a-bobadilla/Smart-Ovitramp/assets/prub1.jpg

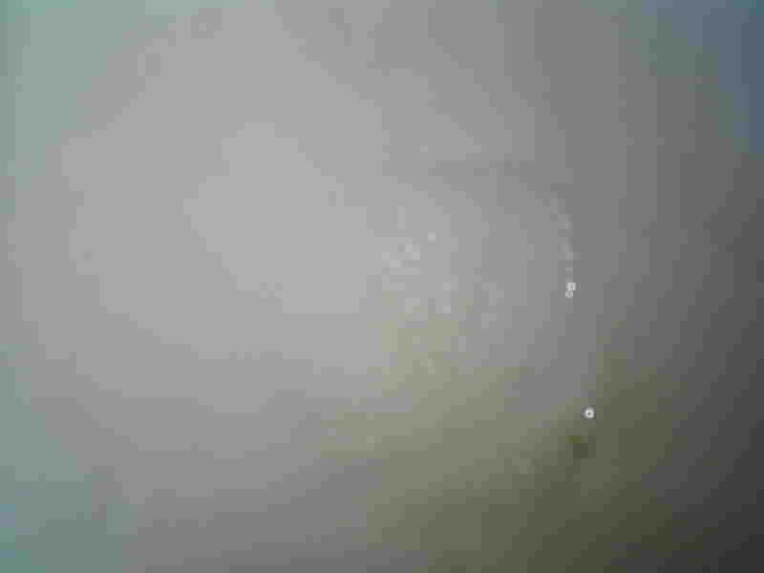
assets/prub1.jpg
