a-bobadilla/Smart-Ovitramp/assets/prub5.jpg

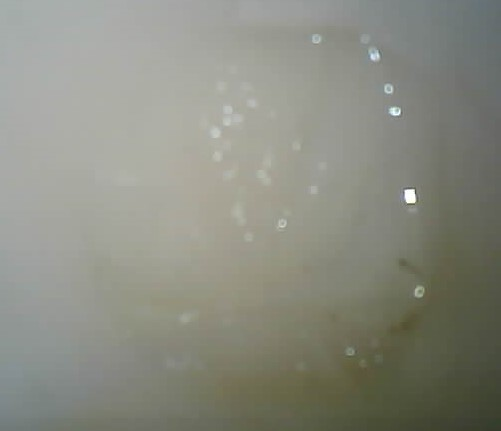
assets/prub5.jpg
