a-bobadilla/Smart-Ovitramp/assets/WIN_20220629_12_00_54_Pro.jpg

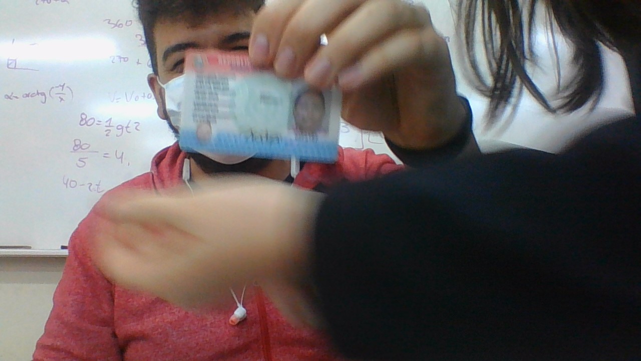
assets/WIN_20220629_12_00_54_Pro.jpg
