a-bobadilla/Smart-Ovitramp/dataset2/202304031346.jpg

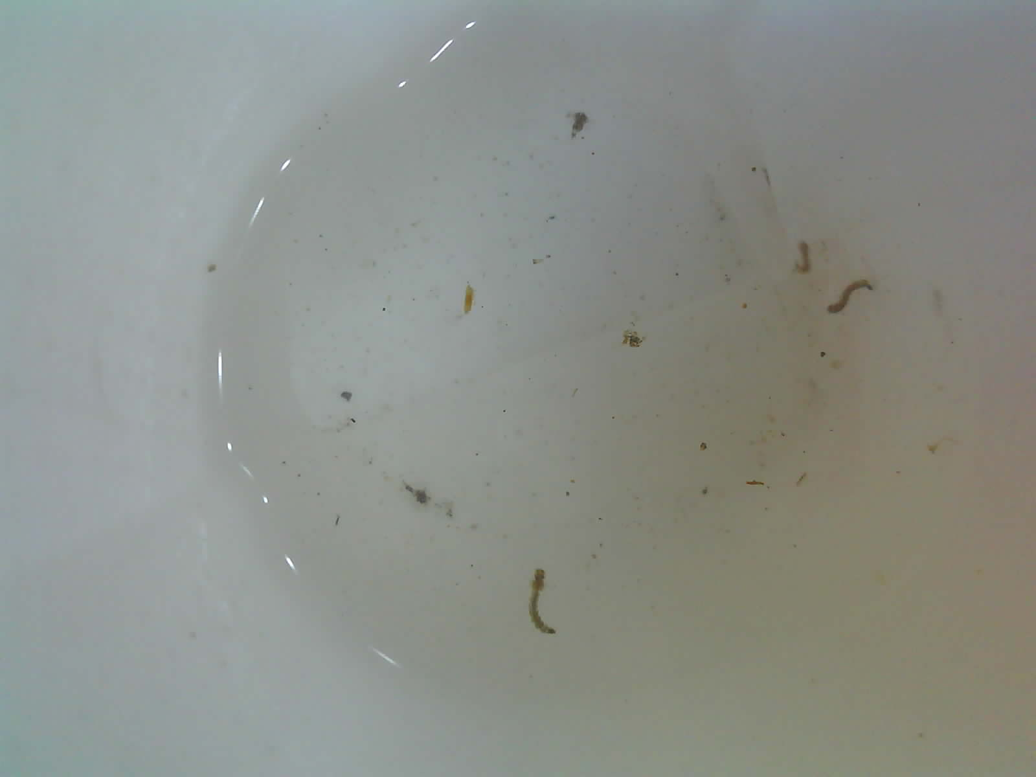
dataset2/202304031346.jpg
