a-bobadilla/Smart-Ovitramp/dataset2/202304031402.jpg

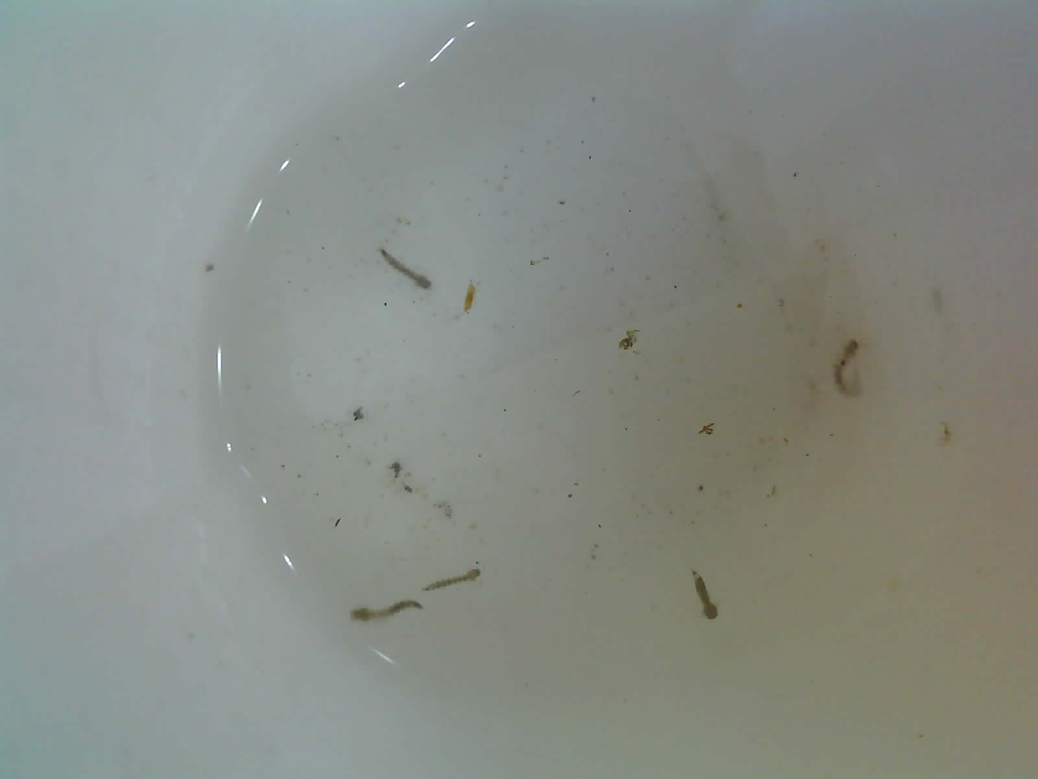
dataset2/202304031402.jpg
