a-bobadilla/Smart-Ovitramp/dataset2/202304031422.jpg

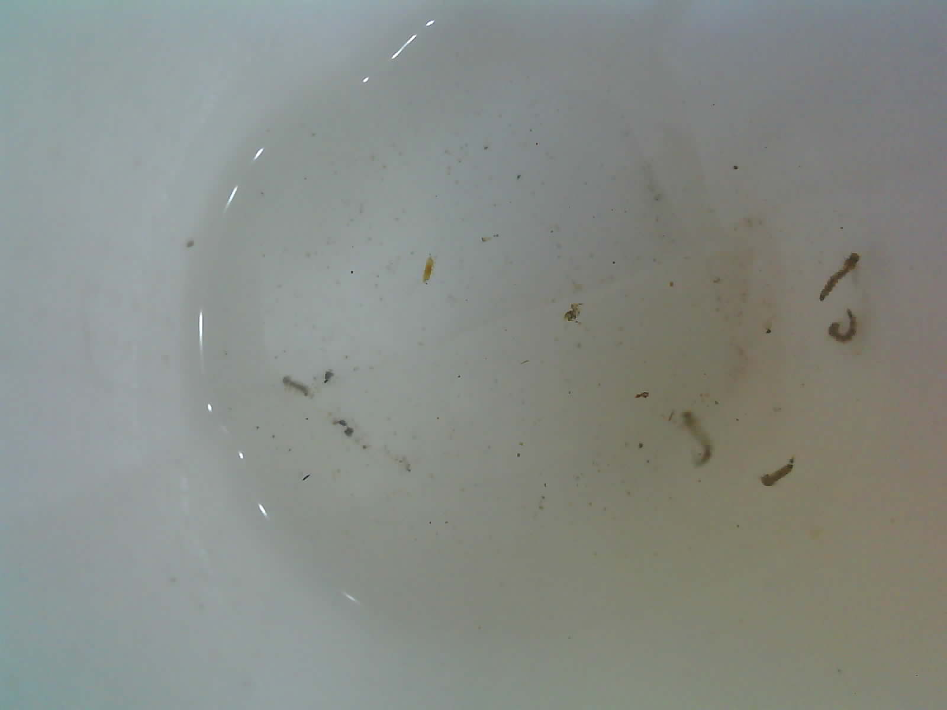
dataset2/202304031422.jpg
