a-bobadilla/Smart-Ovitramp/dataset2/202304031514.jpg

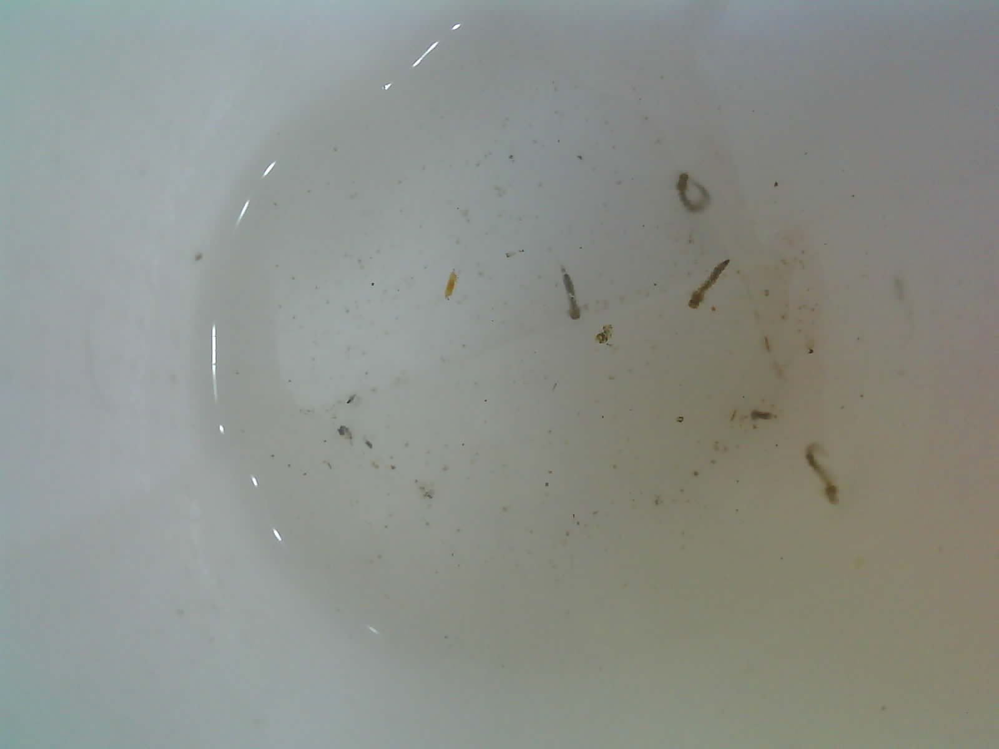
dataset2/202304031514.jpg
