a-bobadilla/Smart-Ovitramp/dataset2/202304031654.jpg

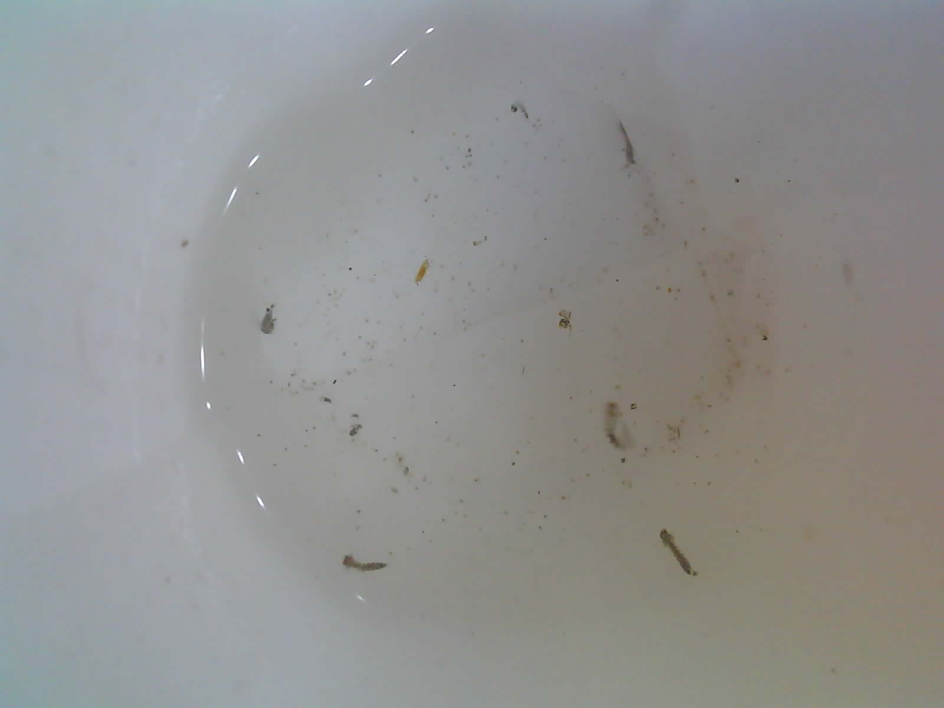
dataset2/202304031654.jpg
