a-bobadilla/Smart-Ovitramp/dataset2/202304031720.jpg

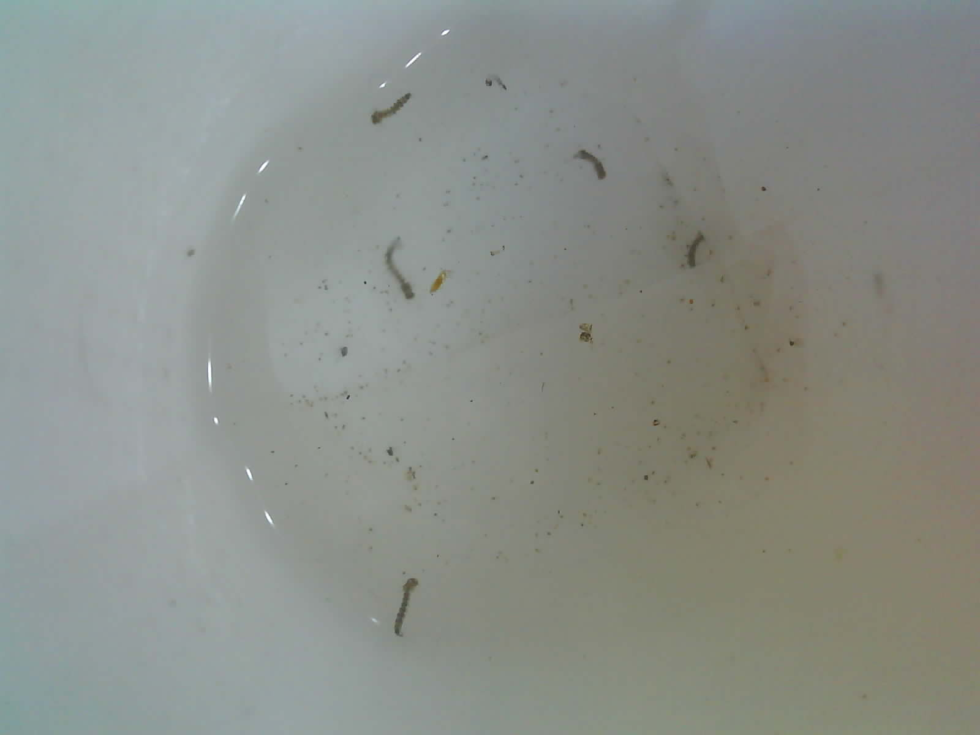
dataset2/202304031720.jpg
