a-bobadilla/Smart-Ovitramp/3D Print/Tapa Complex.obj

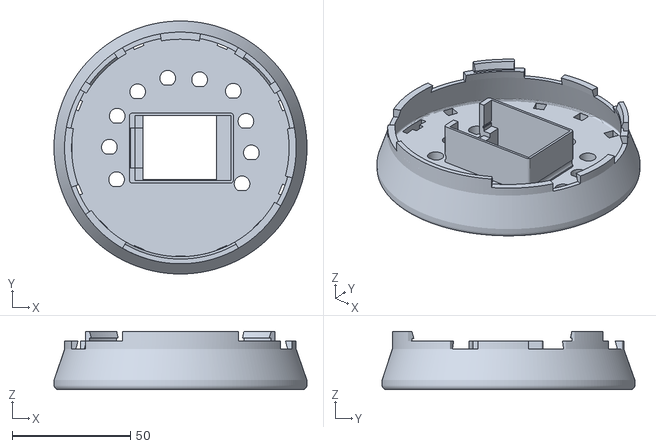
[picture p15: CAD file, 2025-12-15]
3D Print/Tapa Complex.obj
106.8 x 106.8 x 24.7
