a-bobadilla/Smart-Ovitramp/3D Print/Tapa lateral 2.obj

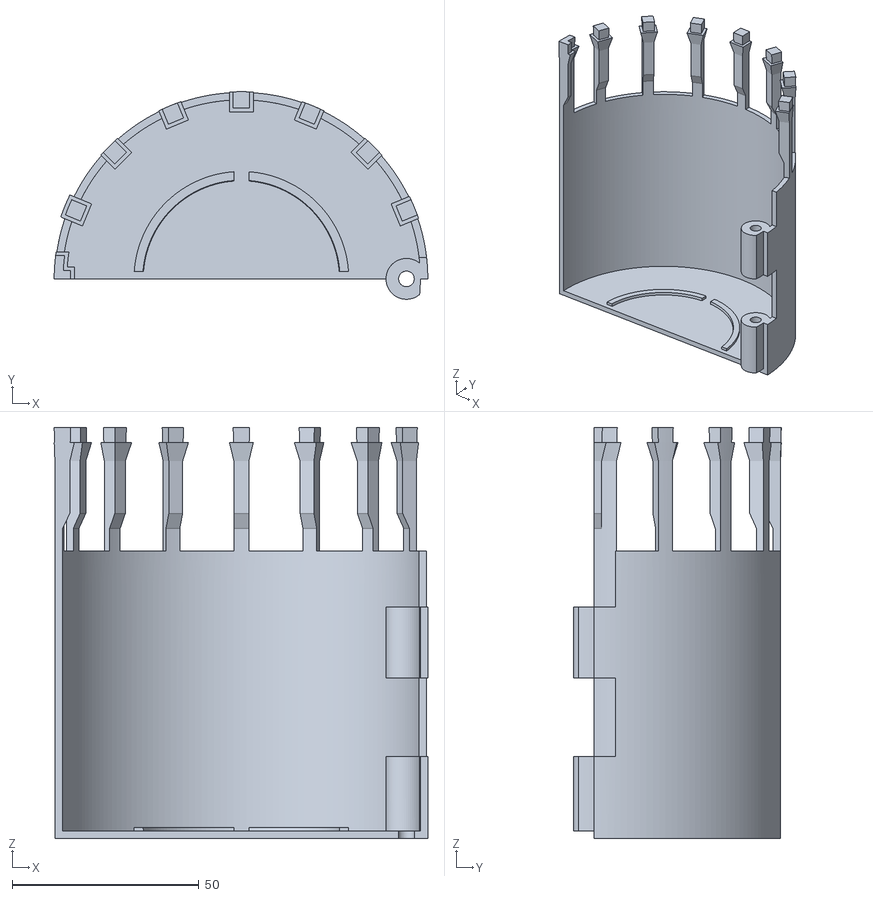
[picture p16: CAD file, 2025-12-15]
3D Print/Tapa lateral 2.obj
100.0 x 55.6 x 110.0
