a-bobadilla/Smart-Ovitramp/3D Print/Tapa Lateral 1.obj

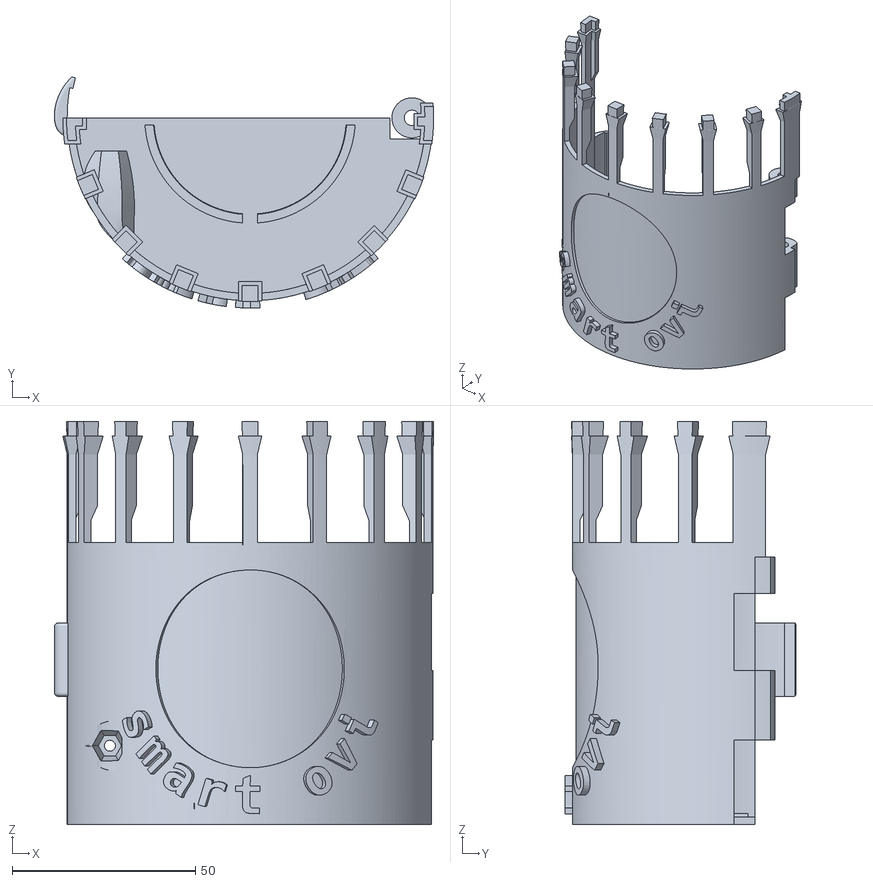
[picture p17: CAD file, 2025-12-15]
3D Print/Tapa Lateral 1.obj
103.5 x 63.1 x 110.0
