a-bobadilla/Smart-Ovitramp/(list of files, drawings)

Other design files:
EasyEDA/ProPrj_SmartOvi v1_2025-12-15.epro
