a-bobadilla/Smart-Ovitramp/assets/prueba.jpg

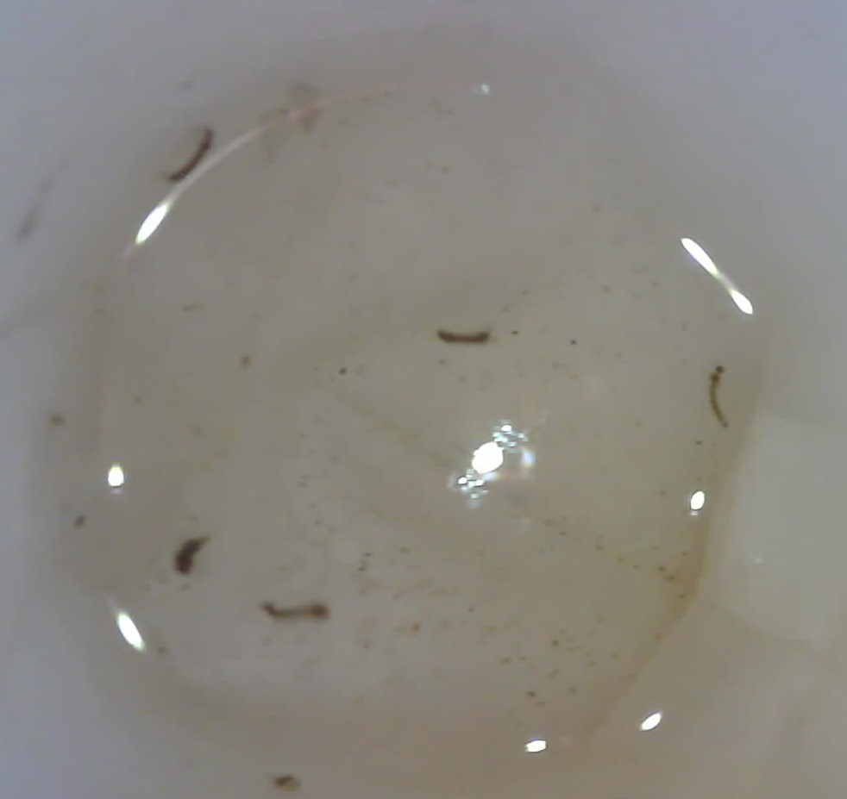
assets/prueba.jpg
