a-bobadilla/Smart-Ovitramp/Resultados/cantidaddemuestrasdetectadasconvision.png

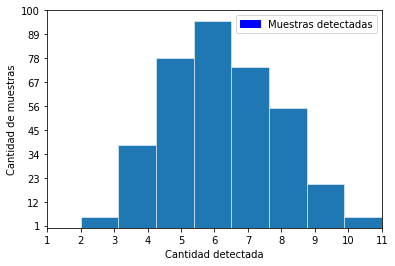
Resultados/cantidaddemuestrasdetectadasconvision.png
