a-bobadilla/Smart-Ovitramp/Resultados/distribuciondemuestrasconvision.png

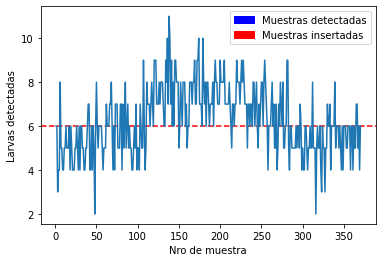
Resultados/distribuciondemuestrasconvision.png
