a-bobadilla/Smart-Ovitramp/Resultados/Resultados de muestras por vision.png

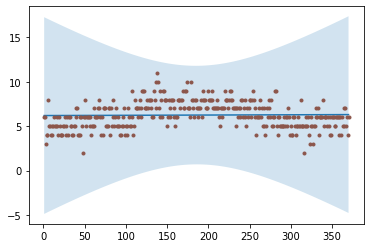
Resultados/Resultados de muestras por vision.png
