a-bobadilla/Smart-Ovitramp/(commit log)

2025-12-15 firts commit
    [ProPrj_SmartOvi v1_2025-12-15.epro, Tapa Complex.obj, Tapa Lateral 1.obj, Tapa lateral 2.obj]
2026-11-02 docs: overhaul README with narrative workflow, 3D animation, and field diagrams
    - Add animated 3D CAD visualization (ovitrampa.gif / ovitrampa.mp4)
    - Include opened ovitrap view, system flowchart, PCB design, and field application diagrams
    - Detail complete English narrative of the ovitrap operation, 6-day maintenance cycle, and IoT-Edge AI architecture
    - Track dataset annotations, notebooks, scripts, results, assets, and requirements
