a-bobadilla/Smart-Ovitramp/(notices)

Notices in the files:
readme.md:
License: MIT
